VM-Thuan-2003/do_an_1/PROJECT/MACH/MACH_THUC/MACH_THUC_PROTEUS/MACH_THANH_PHAN/MACH_NGUON/imgs/tu_hoa_1000uF_25V.jpg

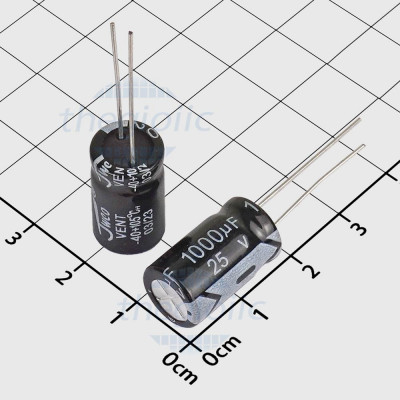
PROJECT/MACH/MACH_THUC/MACH_THUC_PROTEUS/MACH_THANH_PHAN/MACH_NGUON/imgs/tu_hoa_1000uF_25V.jpg
