VM-Thuan-2003/do_an_1/README.md

# PROJECT - ELECTRONIC - 1

> Name project: He thong giam sat nhiet do ho ca va cho ca an tu dong

## 2 MEMBER
* Vo Minh Thuan - 21161366
* Le Quang Thuong - 21161366

>Contact: 0355524273
