VM-Thuan-2003/do_an_1/PROJECT/REPORT/SO_DO_NGUYEN_Y.pdf

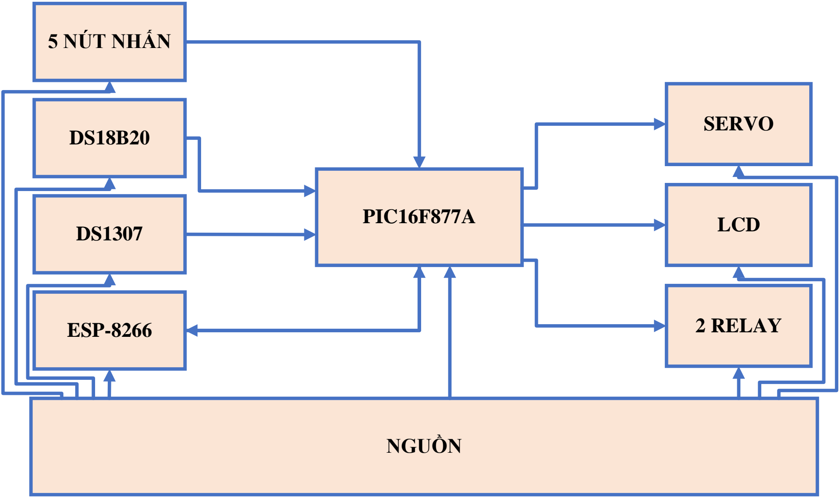
[picture p100: figure]
NGUỒN; PIC16F877A; ESP-8266; 5 NÚT NHẤN; LCD; 2 RELAY; SERVO
