VM-Thuan-2003/do_an_1/DOCUMENTS/Documents.docx

Đồ án 1

Hệ thống giám sát nhiệt độ bể cá và cho cá ăn tự động
