VM-Thuan-2003/do_an_1/PROJECT/MACH/MACH_THUC/MACH_THUC/MACH_THUC/PCF8574AT.STEP

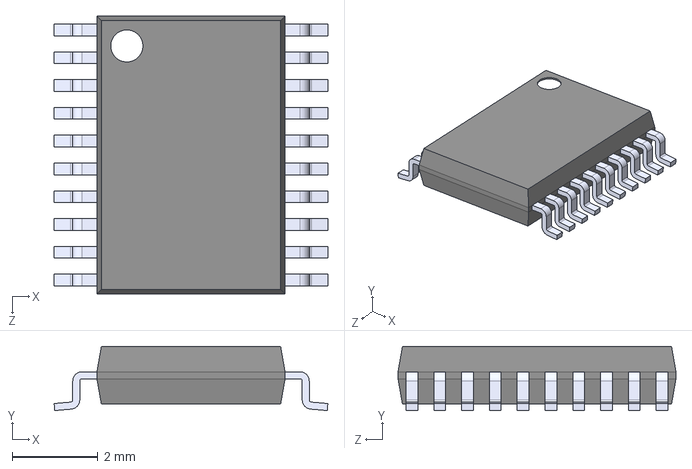
[picture p101: CAD file, 2024-05-01]
PROJECT/MACH/MACH_THUC/MACH_THUC/MACH_THUC/PCF8574AT.STEP
6.40 x 1.50 x 6.50 mm
