VM-Thuan-2003/do_an_1/PROJECT/MACH/MACH_THUC/MACH_THUC/MACH_THUC_V2/MACH_THUC_V2/SS12D07VG4/SS12D07VG4.step

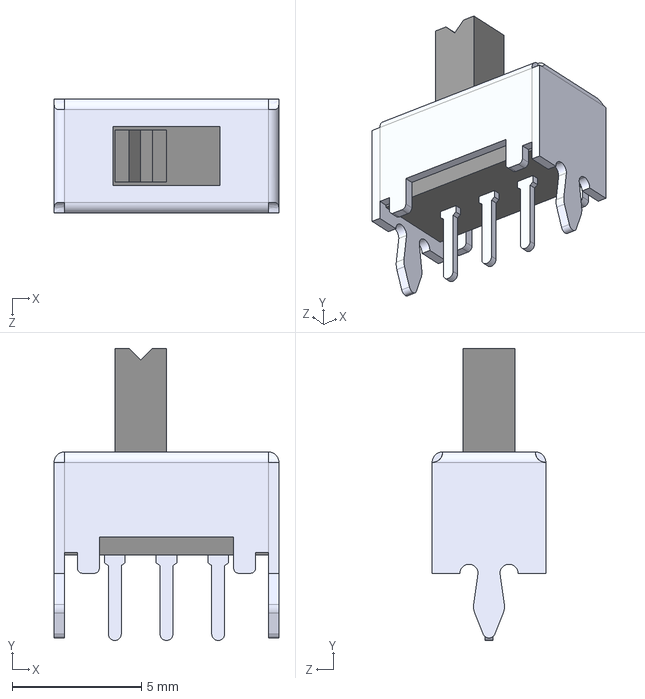
[picture p102: CAD file, 2024-05-01, an earlier design]
PROJECT/MACH/MACH_THUC/MACH_THUC/MACH_THUC_V2/MACH_THUC_V2/SS12D07VG4/SS12D07VG4.step
8.70 x 11.3 x 4.40 mm
