VM-Thuan-2003/do_an_1/PROJECT/MACH/MACH_THUC/MACH_THUC/MACH_THUC_V2/MACH_THUC_V2/1935161/1935161.step

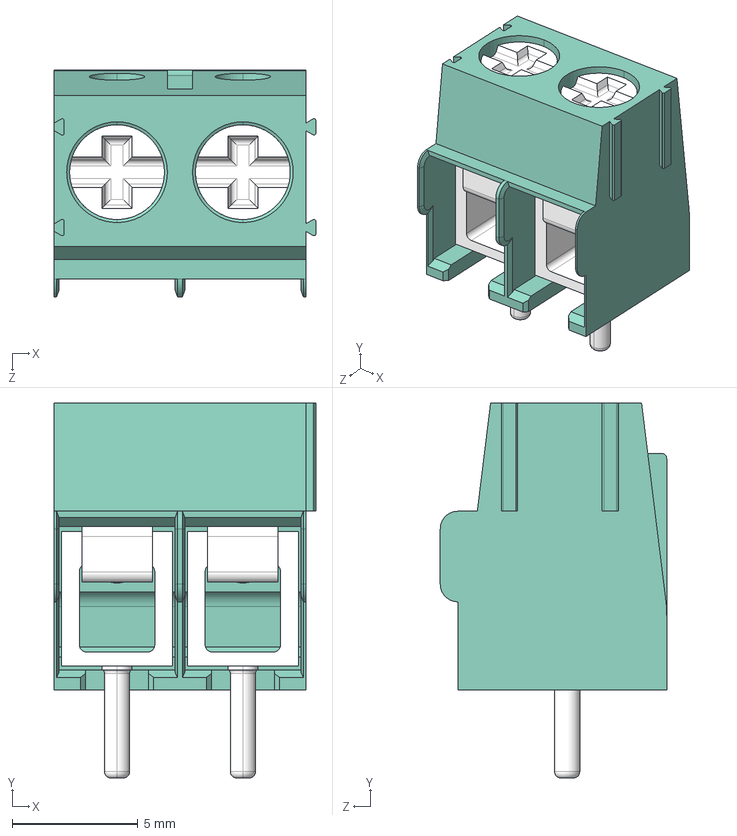
[picture p103: CAD file, 2024-05-01, an earlier design]
PROJECT/MACH/MACH_THUC/MACH_THUC/MACH_THUC_V2/MACH_THUC_V2/1935161/1935161.step
10.4 x 14.9 x 9.00 mm
