VM-Thuan-2003/do_an_1/PROJECT/REPORT/lưu đồ.drawio.pdf

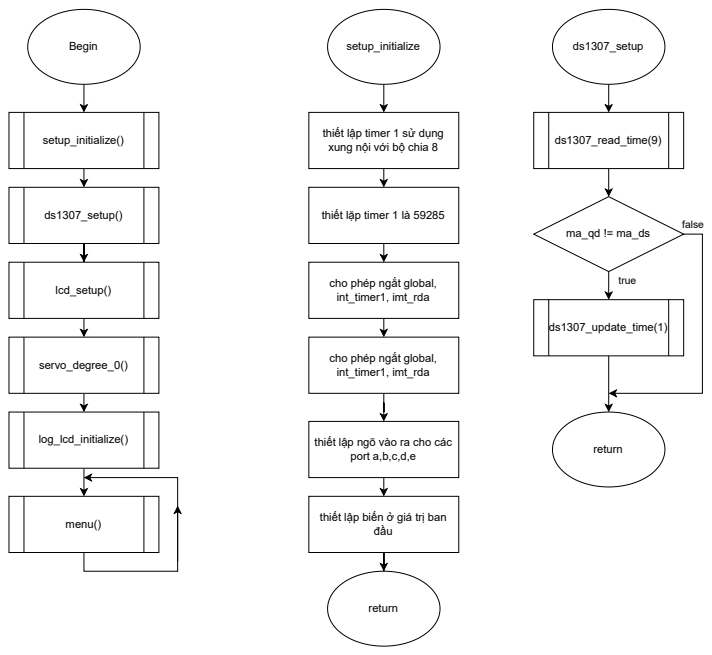
[picture p104: page 1]
Begin; setup_initialize(); ds1307_setup(); lcd_setup(); servo_degree_0(); log_lcd_initialize(); menu(); setup_initialize; đầu; return; ds1307_setup; ds1307_read_time(9); true; false; ds1307_update_time(1)

thiết lập timer 1 sử dụng
xung nội với bộ chia 8

thiết lặp timer 1 là 59285

cho phép ngắt global,
int_timer1, imt_rda

thiết lập ngõ vào ra cho các
port a,b,c,d,e

thiết lập biến ở giá trị ban

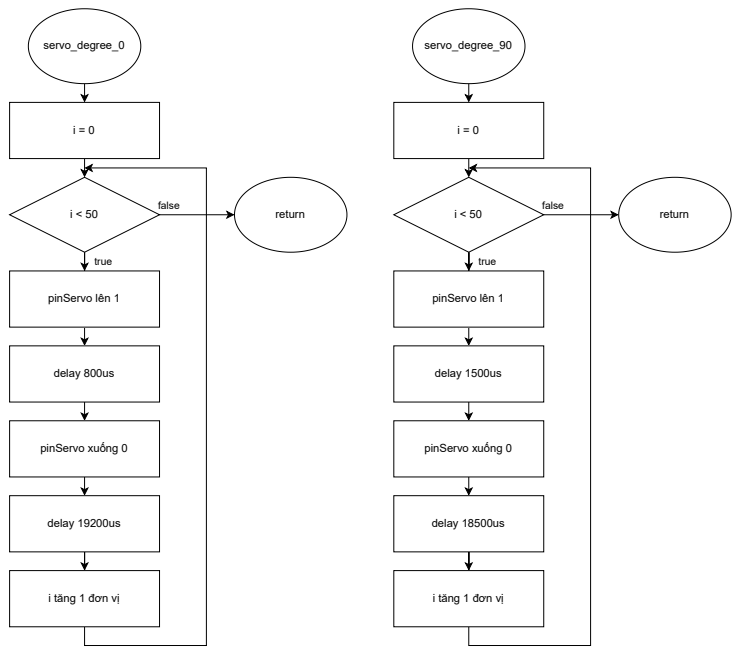
[picture p105: page 2]
servo_degree_0; true; false; pinServo lên 1; delay 800us; pinServo xuống 0; delay 19200us; return; servo_degree_90; delay 1500us; delay 18500us

i tăng 1 đơn vị

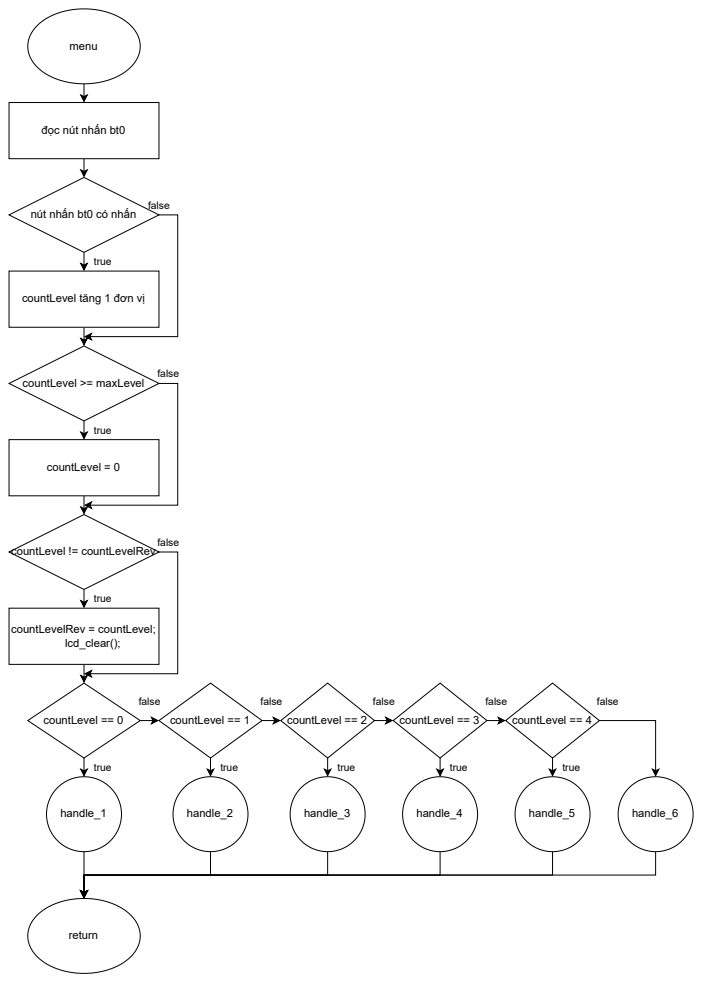
[picture p106: page 3]
menu; true; false; countLevel >= maxLevel; countLevel = 0; countLevel != countLevelRev; countLevelRev = countLevel; lcd_clear();; countLevel == 0; handle_1; countLevel == 1; handle_2; countLevel == 2; handle_3; countLevel == 3; handle_4; countLevel == 4; handle_5; handle_6; return

đọc nút nhấn bt0

false nút nhấn bt0 có nhấn

countLevel tăng 1 đơn vị

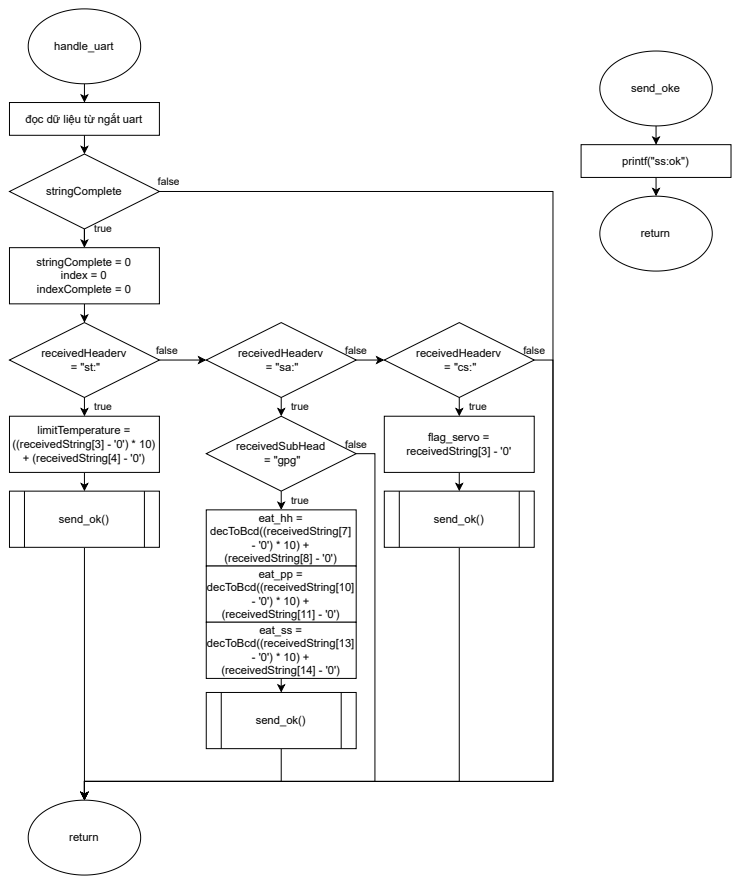
[picture p107: page 4]
handle_uart; true; false; stringComplete; stringComplete = 0 index = 0 indexComplete = 0; receivedHeaderv; limitTemperature = ((receivedString[3] - '0') * 10) + (receivedString[4] - '0'); send_ok(); receivedSubHead; = "gpg"; eat_hh = decToBcd((receivedString[7] - '0') * 10) + (receivedString[8] - '0') eat_pp = decToBcd((receivedString[10] - '0') * 10) + (receivedString[11] - '0') eat_ss = decToBcd((receivedString[13] - '0') * 10) + (receivedString[14] - '0')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

đọc dữ liệu từ ngắt uart

printf("ss:ok")

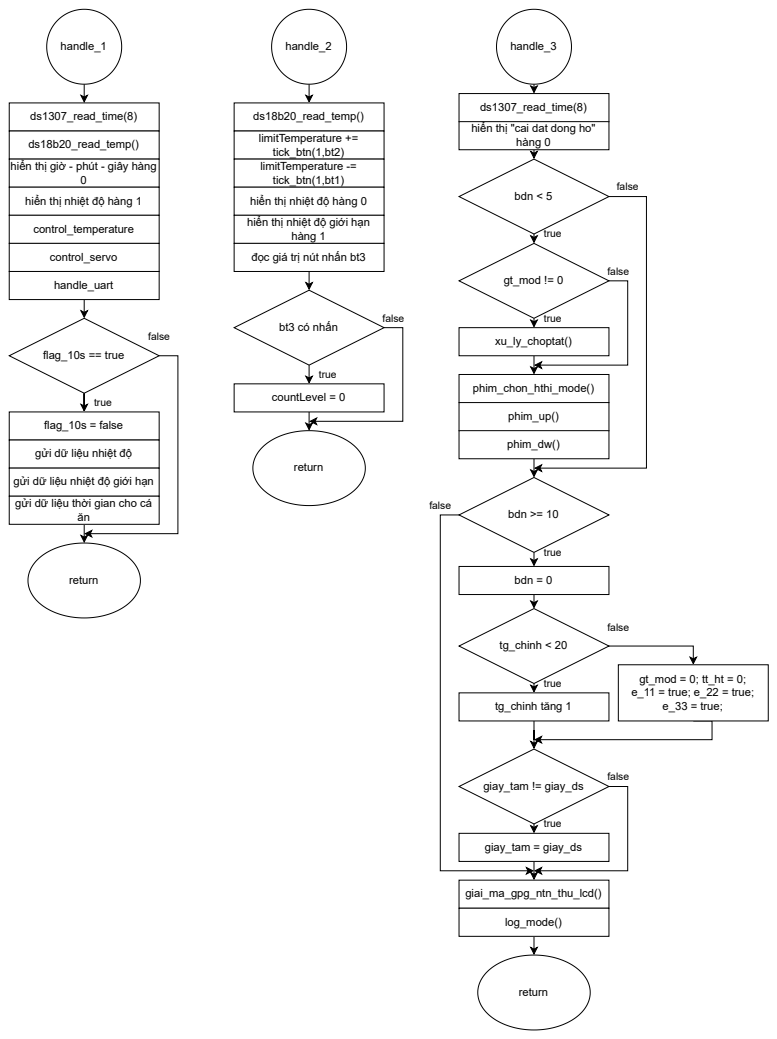
[picture p108: page 5]
ds1307_read_time(8); control_temperature; control_servo; handle_uart; handle_1; true; false; flag_10s == true; return; handle_2; hàng 1; handle_3; hàng 0; bdn < 5; gt_mod != 0; xu_ly_choptat(); bdn >= 10; bdn = 0; tg_chinh < 20; tg_chinh tăng 1; gt_mod = 0; tt_ht = 0; e_11 = true; e_22 = true; e_33 = true;; giay_tam != giay_ds; giay_tam = giay_ds; giai_ma_gpg_ntn_thu_lcd(); log_mode()

ds1307_read_time(8)
hiển thị "cai dat dong ho"

ds18b20_read_temp()
limitTemperature +=
tick_btn(1,bt2)
limitTemperature -=
tick_btn(1,bt1)
hiển thị nhiệt độ hàng 0
hiển thị nhiệt độ giới hạn

hiển thị giờ - phút - giây hàng

hiển thị nhiệt độ hàng 1

đọc giá trị nút nhấn bt3

false bt3 có nhấn

phim_chon_hthi_mode()

countLevel = 0

phim_up()

flag_10s = false

phim_dw()

gửi dữ liệu nhiệt độ

gửi dữ liệu nhiệt độ giới hạn

gửi dữ liệu thời gian cho cá

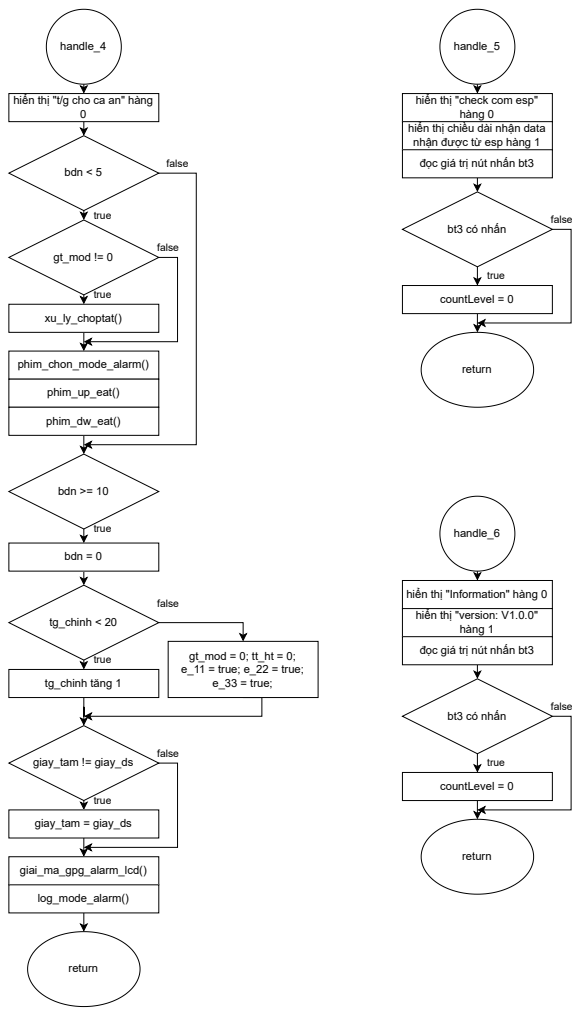
[picture p109: page 6]
handle_4; true; false; bdn < 5; gt_mod != 0; xu_ly_choptat(); bdn >= 10; bdn = 0; tg_chinh < 20; tg_chinh tăng 1; gt_mod = 0; tt_ht = 0; e_11 = true; e_22 = true; e_33 = true;; giay_tam != giay_ds; giay_tam = giay_ds; giai_ma_gpg_alarm_lcd(); log_mode_alarm(); return; handle_5; hàng 0; countLevel = 0; handle_6; hàng 1

hiển thị "t/g cho ca an" hàng

hiển thị "check com esp"

hiển thị chiều dài nhận data
nhận được từ esp hàng 1
đọc giá trị nút nhấn bt3

false bt3 có nhấn

phim_chon_mode_alarm()

phim_up_eat()

phim_dw_eat()

hiển thị "Information" hàng 0
hiển thị "version: V1.0.0"

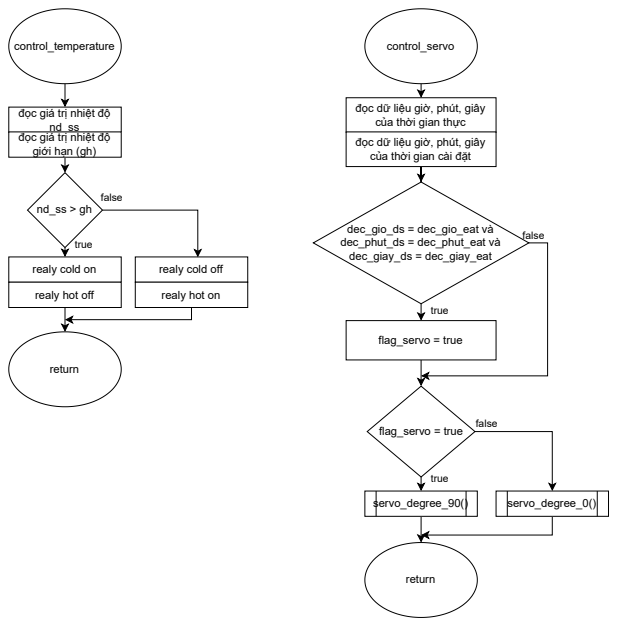
[picture p110: page 7]
control_temperature; true; false; return; control_servo; false dec_gio_ds = dec_gio_eat và dec_phut_ds = dec_phut_eat và dec_giay_ds = dec_giay_eat; flag_servo = true; servo_degree_90(); servo_degree_0()

đọc dữ liệu giờ, phút, giây
của thời gian thực
của thời gian cài đặt

đọc giá trị nhiệt độ
giới hạn (gh)

realy cold on

realy cold off

realy hot off

realy hot on

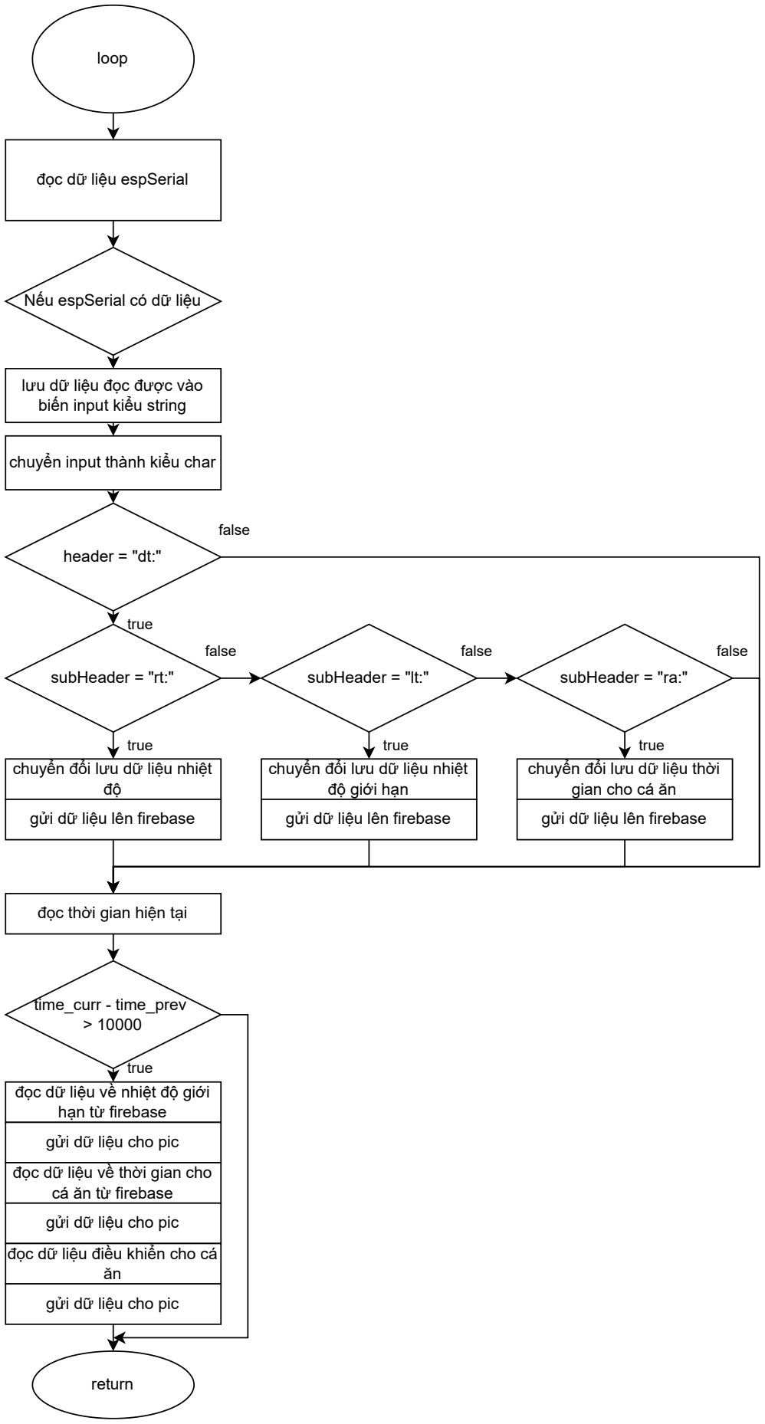
[picture p111: figure]
loop; đọc dữ liệu espSerial; Nếu espSerial có dữ liệu; lưu dữ liệu đọc được vào biến input kiểu string; chuyển input thành kiểu char; true; false; header = "dt:"; subHeader = "rt:"; chuyển đổi lưu dữ liệu nhiệt độ; gửi dữ liệu lên firebase; subHeader = "lt:"; chuyển đổi lưu dữ liệu nhiệt độ giới hạn; subHeader = "ra:"; chuyển đổi lưu dữ liệu thời gian cho cá ăn; đọc thời gian hiện tại; time_curr - time_prev > 10000; gửi dữ liệu cho pic; đọc dữ liệu điều khiển cho cá ăn; return

đọc dữ liệu về nhiệt độ giới hạn từ firebase

đọc dữ liệu về thời gian cho cá ăn từ firebase

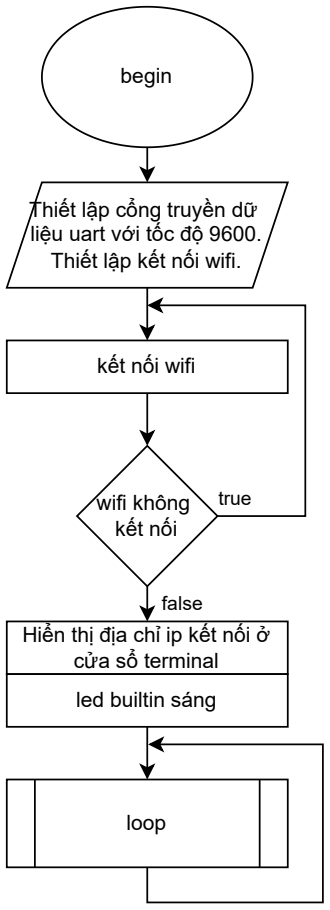
[picture p112: figure]
begin; Thiết lập cổng truyền dữ liệu uart với tốc độ 9600. Thiết lập kết nối wifi.; kết nối wifi; true; false; wifi không kết nối; Hiển thị địa chỉ ip kết nối ở cửa sổ terminal; led builtin sáng; loop
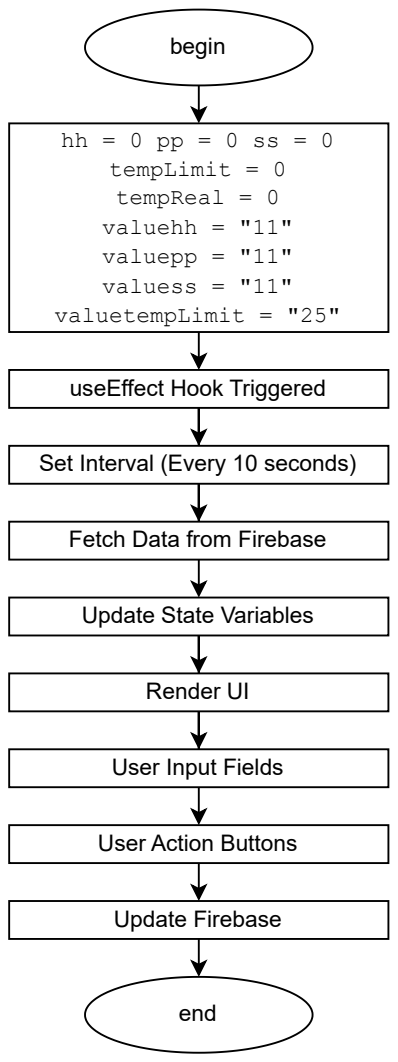
[picture p113: page 10]
begin; hh = 0 pp = 0 ss = 0 tempLimit = 0 tempReal = 0 valuehh = "11" valuepp = "11" valuess = "11" valuetempLimit = "25"; Render UI; Update Firebase; end

useEffect Hook Triggered

Set Interval (Every 10 seconds)

Fetch Data from Firebase

Update State Variables

User Input Fields

User Action Buttons
