VM-Thuan-2003/do_an_1/PROJECT/MACH/MACH_THUC/MACH_THUC/MACH_THUC/MACH_THUC.pdf

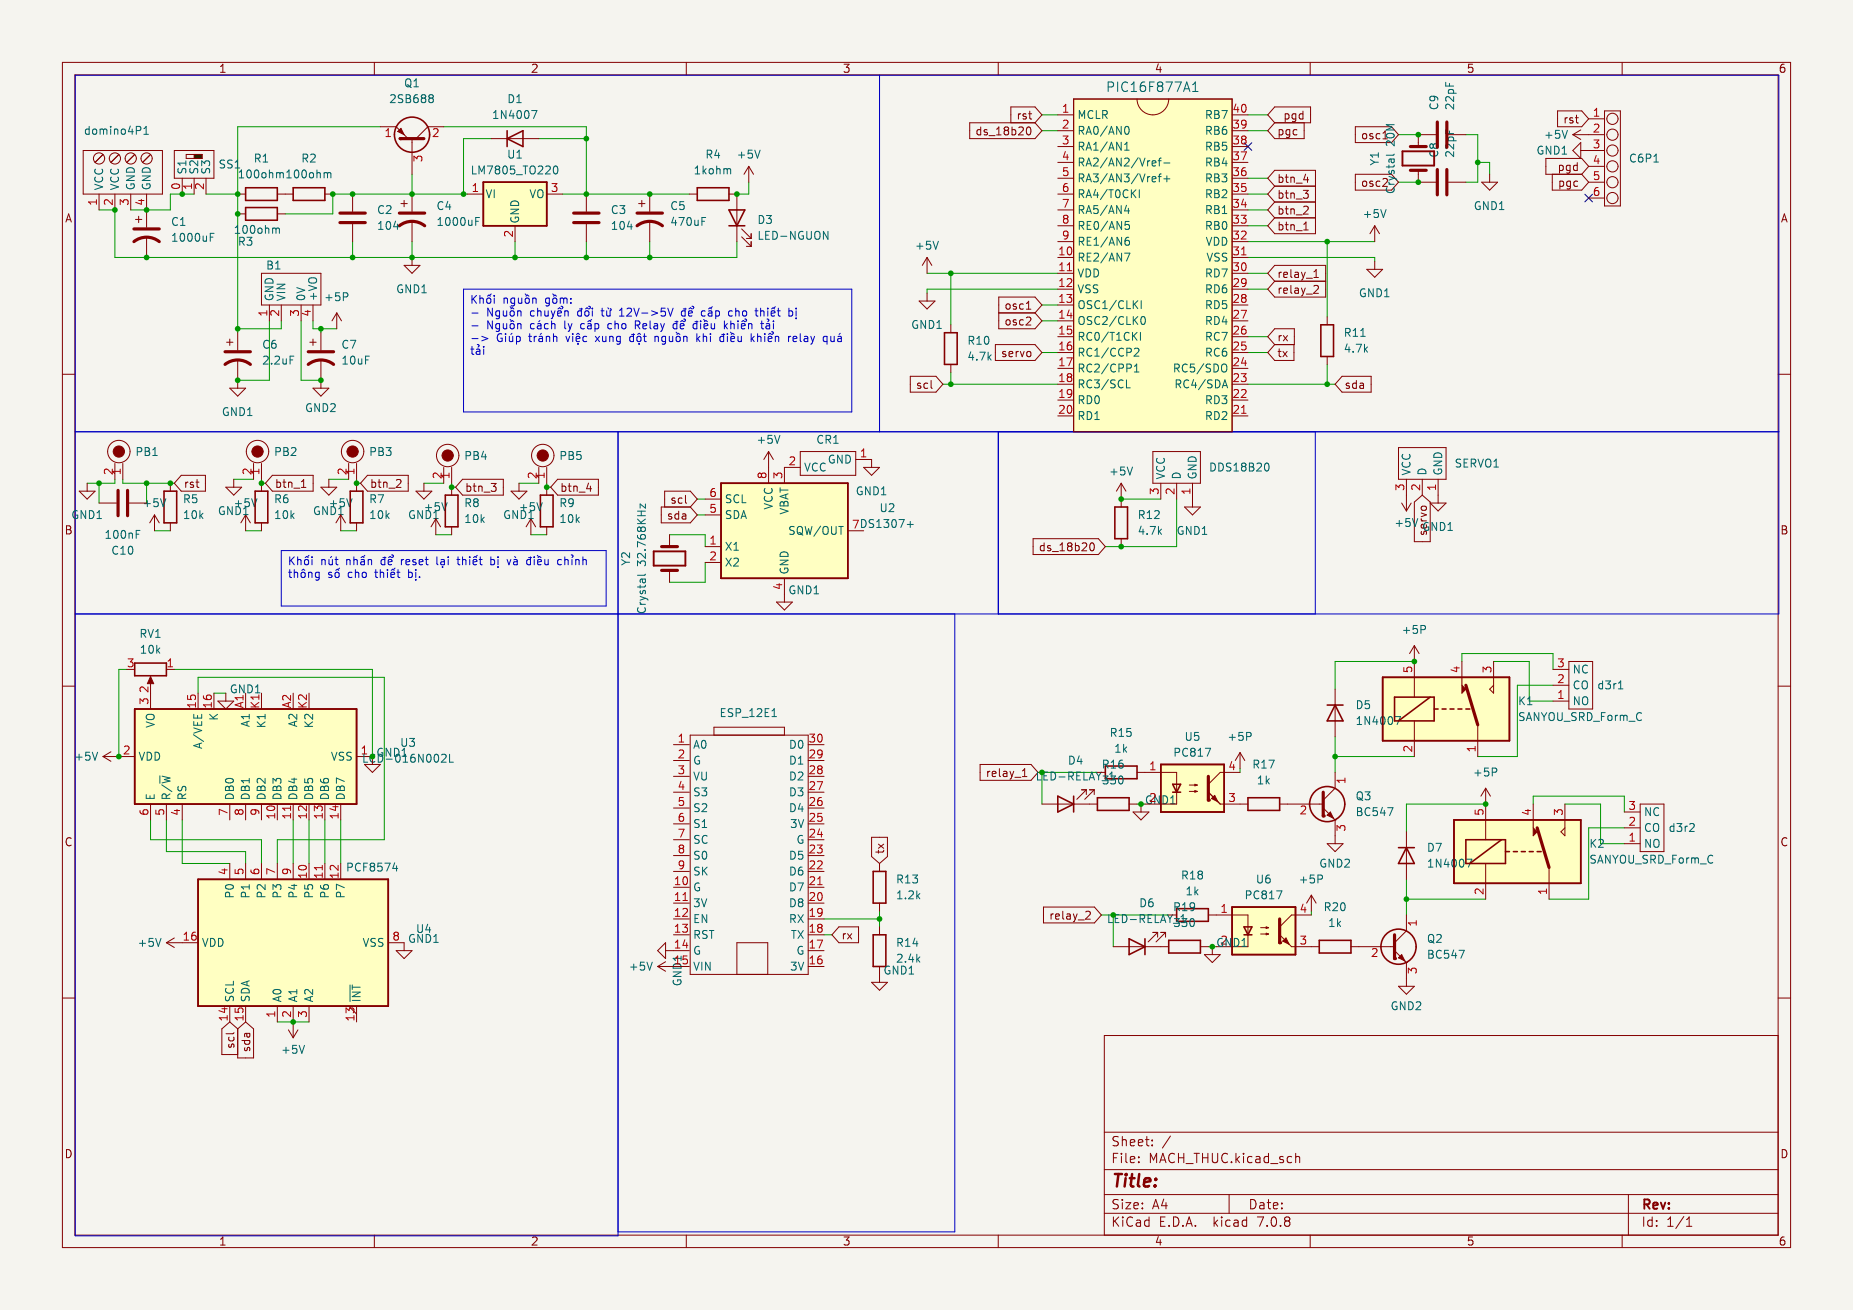
[picture p114: page 1]
