VM-Thuan-2003/do_an_1/(list of files, drawings)

Other design files:
PROJECT/MACH/MACH_THUC/MACH_THUC/MACH_THUC/MACH_THUC - Copy.dsn
PROJECT/MACH/MACH_THUC/MACH_THUC/MACH_THUC/MACH_THUC.dsn
PROJECT/MACH/MACH_THUC/MACH_THUC_PROTEUS/MACH_THANH_PHAN/MACH_NGUON/MACH_NGUON.pdsprj
PROJECT/MACH/MACH_THUC/MACH_THUC_PROTEUS/MACH_THANH_PHAN/MACH_NGUON/Project Backups/MACH_NGUON [20240402, 16-22-32].pdsprj
PROJECT/MACH/MACH_THUC/MACH_THUC_PROTEUS/MACH_THANH_PHAN/MACH_NGUON/Project Backups/MACH_NGUON [20240402, 16-22-33].pdsprj
PROJECT/MACH/MACH_THUC/MACH_THUC_PROTEUS/MACH_THANH_PHAN/MACH_NGUON/Project Backups/MACH_NGUON [20240402, 16-24-22].pdsprj
PROJECT/MACH/MACH_THUC/MACH_THUC_PROTEUS/MACH_THANH_PHAN/MACH_NGUON/Project Backups/MACH_NGUON [20240402, 16-24-23].pdsprj
PROJECT/MACH/MACH_THUC/MACH_THUC_PROTEUS/MACH_THANH_PHAN/MACH_NGUON/Project Backups/MACH_NGUON [20240402, 16-24-24].pdsprj
PROJECT/MACH/MACH_THUC/MACH_THUC_PROTEUS/MACH_THANH_PHAN/MACH_NGUON/Project Backups/MACH_NGUON [20240402, 16-24-25].pdsprj
PROJECT/MACH/MACH_THUC/MACH_THUC_PROTEUS/MACH_THANH_PHAN/MACH_NGUON/Project Backups/MACH_NGUON [20240403, 22-24-05].pdsprj
PROJECT/MACH/MACH_THUC/MACH_THUC_PROTEUS/MACH_THANH_PHAN/MACH_NGUON/Project Backups/MACH_NGUON [20240403, 22-24-06].pdsprj
PROJECT/MACH/MACH_THUC/MACH_THUC_PROTEUS/MACH_THANH_PHAN/MACH_RELAY/MACH_RELAY.pdsprj
PROJECT/MACH/MACH_THUC/MACH_THUC_PROTEUS/MACH_THANH_PHAN/MACH_RELAY/Project Backups/MACH_RELAY [20240403, 23-06-09].pdsprj
PROJECT/MACH/MACH_THUC/MACH_THUC_PROTEUS/MACH_THANH_PHAN/MACH_RELAY/Project Backups/MACH_RELAY [20240403, 23-26-44].pdsprj
PROJECT/MACH/MACH_THUC/MACH_THUC_PROTEUS/MACH_THANH_PHAN/MACH_RELAY/Project Backups/MACH_RELAY [20240403, 23-26-47].pdsprj
PROJECT/MACH/MACH_THUC/MACH_THUC_PROTEUS/MACH_THANH_PHAN/MACH_RELAY/Project Backups/MACH_RELAY [20240403, 23-26-48].pdsprj
PROJECT/MACH/MACH_THUC/MACH_THUC_PROTEUS/MACH_THANH_PHAN/MACH_RELAY/Project Backups/MACH_RELAY [20240403, 23-26-57].pdsprj
PROJECT/MACH/MACH_THUC/MACH_THUC_PROTEUS/MACH_THANH_PHAN/MACH_RELAY/Project Backups/MACH_RELAY [20240403, 23-36-37].pdsprj
PROJECT/MACH/MACH_THUC/MACH_THUC_PROTEUS/MACH_TONG_HOP/MACH_FINAL_V1.pdsprj
PROJECT/MACH/MACH_THUC/MACH_THUC_PROTEUS/MACH_TONG_HOP/MACH_TONG_HOP_V2.pdsprj
PROJECT/MACH/MACH_THUC/MACH_THUC_PROTEUS/MACH_TONG_HOP/Project Backups/MACH_TONG_HOP_V2 [20240403, 20-49-37].pdsprj
PROJECT/MACH/MACH_THUC/MACH_THUC_PROTEUS/MACH_TONG_HOP/Project Backups/MACH_TONG_HOP_V2 [20240403, 21-09-36].pdsprj
PROJECT/MACH/MACH_THUC/MACH_THUC_PROTEUS/MACH_TONG_HOP/Project Backups/MACH_TONG_HOP_V2 [20240403, 22-24-31].pdsprj
PROJECT/MACH/MACH_THUC/MACH_THUC_PROTEUS/MACH_TONG_HOP/Project Backups/MACH_TONG_HOP_V2 [20240403, 23-36-59].pdsprj
PROJECT/MACH/MACH_THUC/MACH_THUC_PROTEUS/MACH_TONG_HOP/Project Backups/MACH_TONG_HOP_V2 [20240403, 23-39-41].pdsprj
PROJECT/MACH/MACH_THUC/MACH_THUC_PROTEUS/MACH_TONG_HOP/Project Backups/MACH_TONG_HOP_V2 [20240403, 23-45-08].pdsprj
PROJECT/MACH/MACH_THUC/MACH_THUC_PROTEUS/MACH_TONG_HOP/Project Backups/MACH_TONG_HOP_V2 [20240403, 23-45-09].pdsprj
PROJECT/MACH/MACH_THUC/MACH_THUC_PROTEUS/MACH_TONG_HOP/Project Backups/MACH_TONG_HOP_V2 [20240403, 23-45-14].pdsprj
PROJECT/MACH/MO_PHONG/CIRCIL_FINAL/MACH_FINAL.pdsprj
PROJECT/MACH/MO_PHONG/CIRCIL_FINAL/Project Backups/MACH_FINAL [20240315, 19-27-27].pdsprj
PROJECT/MACH/MO_PHONG/CIRCIL_FINAL/Project Backups/MACH_FINAL [20240315, 19-27-28].pdsprj
PROJECT/MACH/MO_PHONG/CIRCIL_FINAL/Project Backups/MACH_FINAL [20240315, 19-32-34].pdsprj
PROJECT/MACH/MO_PHONG/CIRCIL_FINAL/Project Backups/MACH_FINAL [20240317, 08-32-04].pdsprj
PROJECT/MACH/MO_PHONG/CIRCIL_FINAL/Project Backups/MACH_FINAL [20240319, 15-47-52].pdsprj
PROJECT/MACH/MO_PHONG/CIRCIL_FINAL/Project Backups/MACH_FINAL [20240319, 15-49-03].pdsprj
PROJECT/MACH/MO_PHONG/CIRCIL_FINAL/Project Backups/MACH_FINAL [20240319, 15-49-04].pdsprj
PROJECT/MACH/MO_PHONG/CIRCIL_FINAL/Project Backups/MACH_FINAL [20240320, 13-40-21].pdsprj
PROJECT/MACH/MO_PHONG/CIRCIL_FINAL/Project Backups/MACH_FINAL [20240320, 13-40-22].pdsprj
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
