VM-Thuan-2003/do_an_1/PROJECT/MACH/MACH_THUC/MACH_THUC/MACH_THUC_V2/MACH_THUC_V2/MACH_THUC_V2.kicad_pcb

## KiCad design PROJECT/MACH/MACH_THUC/MACH_THUC/MACH_THUC_V2/MACH_THUC_V2/MACH_THUC_V2.kicad_pcb (2024-05-03, an earlier design)

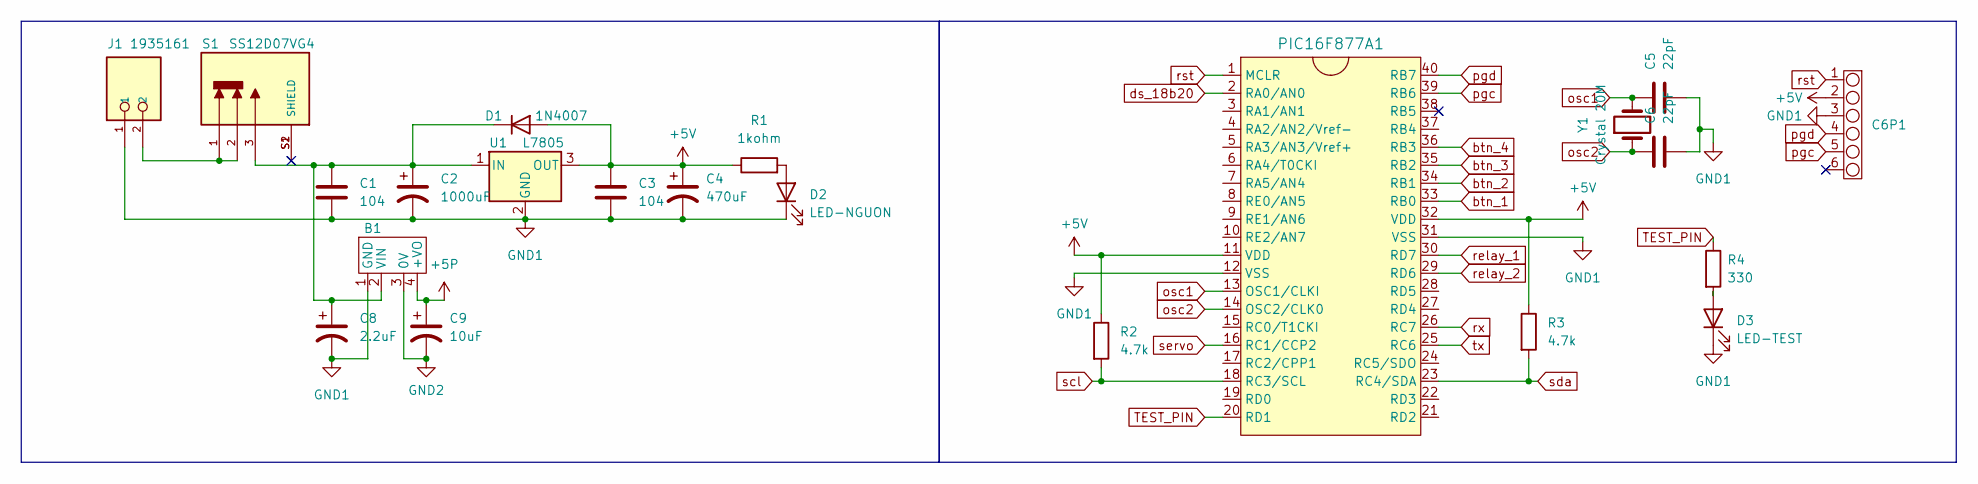
[picture p115: schematic MACH_THUC_V2.kicad_sch]

Parts:
B1: B1205S-1WR3_12_5V
C1, C3: 104; CAP_104
C2: 1000uF; CAP_1000uF
C4: 470uF; CAP_470uF
C5, C6: 22pF; CAP_104
C6P1: CONNECT_6PIN
C8: 2.2uF; CAP_2.2uF
C9: 10uF; CAP_10uF
D1: 1N4007
D2: LED-NGUON; LED_5MM
D3: LED-TEST; LED_5MM
J1: 1935161; PHOENIX_1935161; PARTREV 14.12.2022
PIC16F877A1: PIC_16F877A
R1: 1kohm; RES_DEFAULT
R2, R3: 4.7k; RES_DEFAULT
R4: 330; RES_DEFAULT
S1: SS12D07VG4; SW_SS12D07VG4; PARTREV 1
U1: L7805; TO255P1020X450X2000-3
Y1: Crystal 20M; crytal_20M

Connections:
pgd: C6P1.4, PIC16F877A1.40 (RB7)
+5P: B1.4 (+VO), C9.1
+5V: C3.1, C4.1, C6P1.2, D1.2 (A), PIC16F877A1.11 (VDD), PIC16F877A1.32 (VDD), R1.1, R2.1, R3.1, U1.3 (OUT)
GND1: B1.1 (GND), C1.2, C2.2, C3.2, C4.2, C5.2, C6.2, C6P1.3, C8.2, D2.1 (K), D3.1 (K), J1.1, PIC16F877A1.12 (VSS), PIC16F877A1.31 (VSS), U1.2 (GND)
GND2: B1.3 (0V), C9.2
unnamed: B1.2 (VIN), C1.1, C2.1, C8.1, D1.1 (K), S1.3, U1.1 (IN)
unnamed: D2.2 (A), R1.2
unnamed: D3.2 (A), R4.2
unnamed: J1.2, S1.1, S1.2
TEST_PIN: PIC16F877A1.20 (RD1), R4.1
btn_1: PIC16F877A1.33 (RB0)
btn_2: PIC16F877A1.34 (RB1)
btn_3: PIC16F877A1.35 (RB2)
btn_4: PIC16F877A1.36 (RB3)
ds_18b20: PIC16F877A1.2 (RA0/AN0)
osc1: C5.1, PIC16F877A1.13 (OSC1/CLKI), Y1.2
osc2: C6.1, PIC16F877A1.14 (OSC2/CLK0), Y1.1
pgc: C6P1.5, PIC16F877A1.39 (RB6)
relay_1: PIC16F877A1.30 (RD7)
relay_2: PIC16F877A1.29 (RD6)
rst: C6P1.1, PIC16F877A1.1 (MCLR)
rx: PIC16F877A1.26 (RC7)
scl: PIC16F877A1.18 (RC3/SCL), R2.2
sda: PIC16F877A1.23 (RC4/SDA), R3.2
servo: PIC16F877A1.16 (RC1/CCP2)
tx: PIC16F877A1.25 (RC6)

Board: 2 copper layers, 22 parts (0 on the bottom side), 16 nets, no tracks yet.
