VM-Thuan-2003/do_an_1/PROJECT/MACH/MACH_THUC/MACH_THUC/MACH_THUC/MACH_THUC.kicad_pcb

## KiCad design PROJECT/MACH/MACH_THUC/MACH_THUC/MACH_THUC/MACH_THUC.kicad_pcb (2024-05-01)

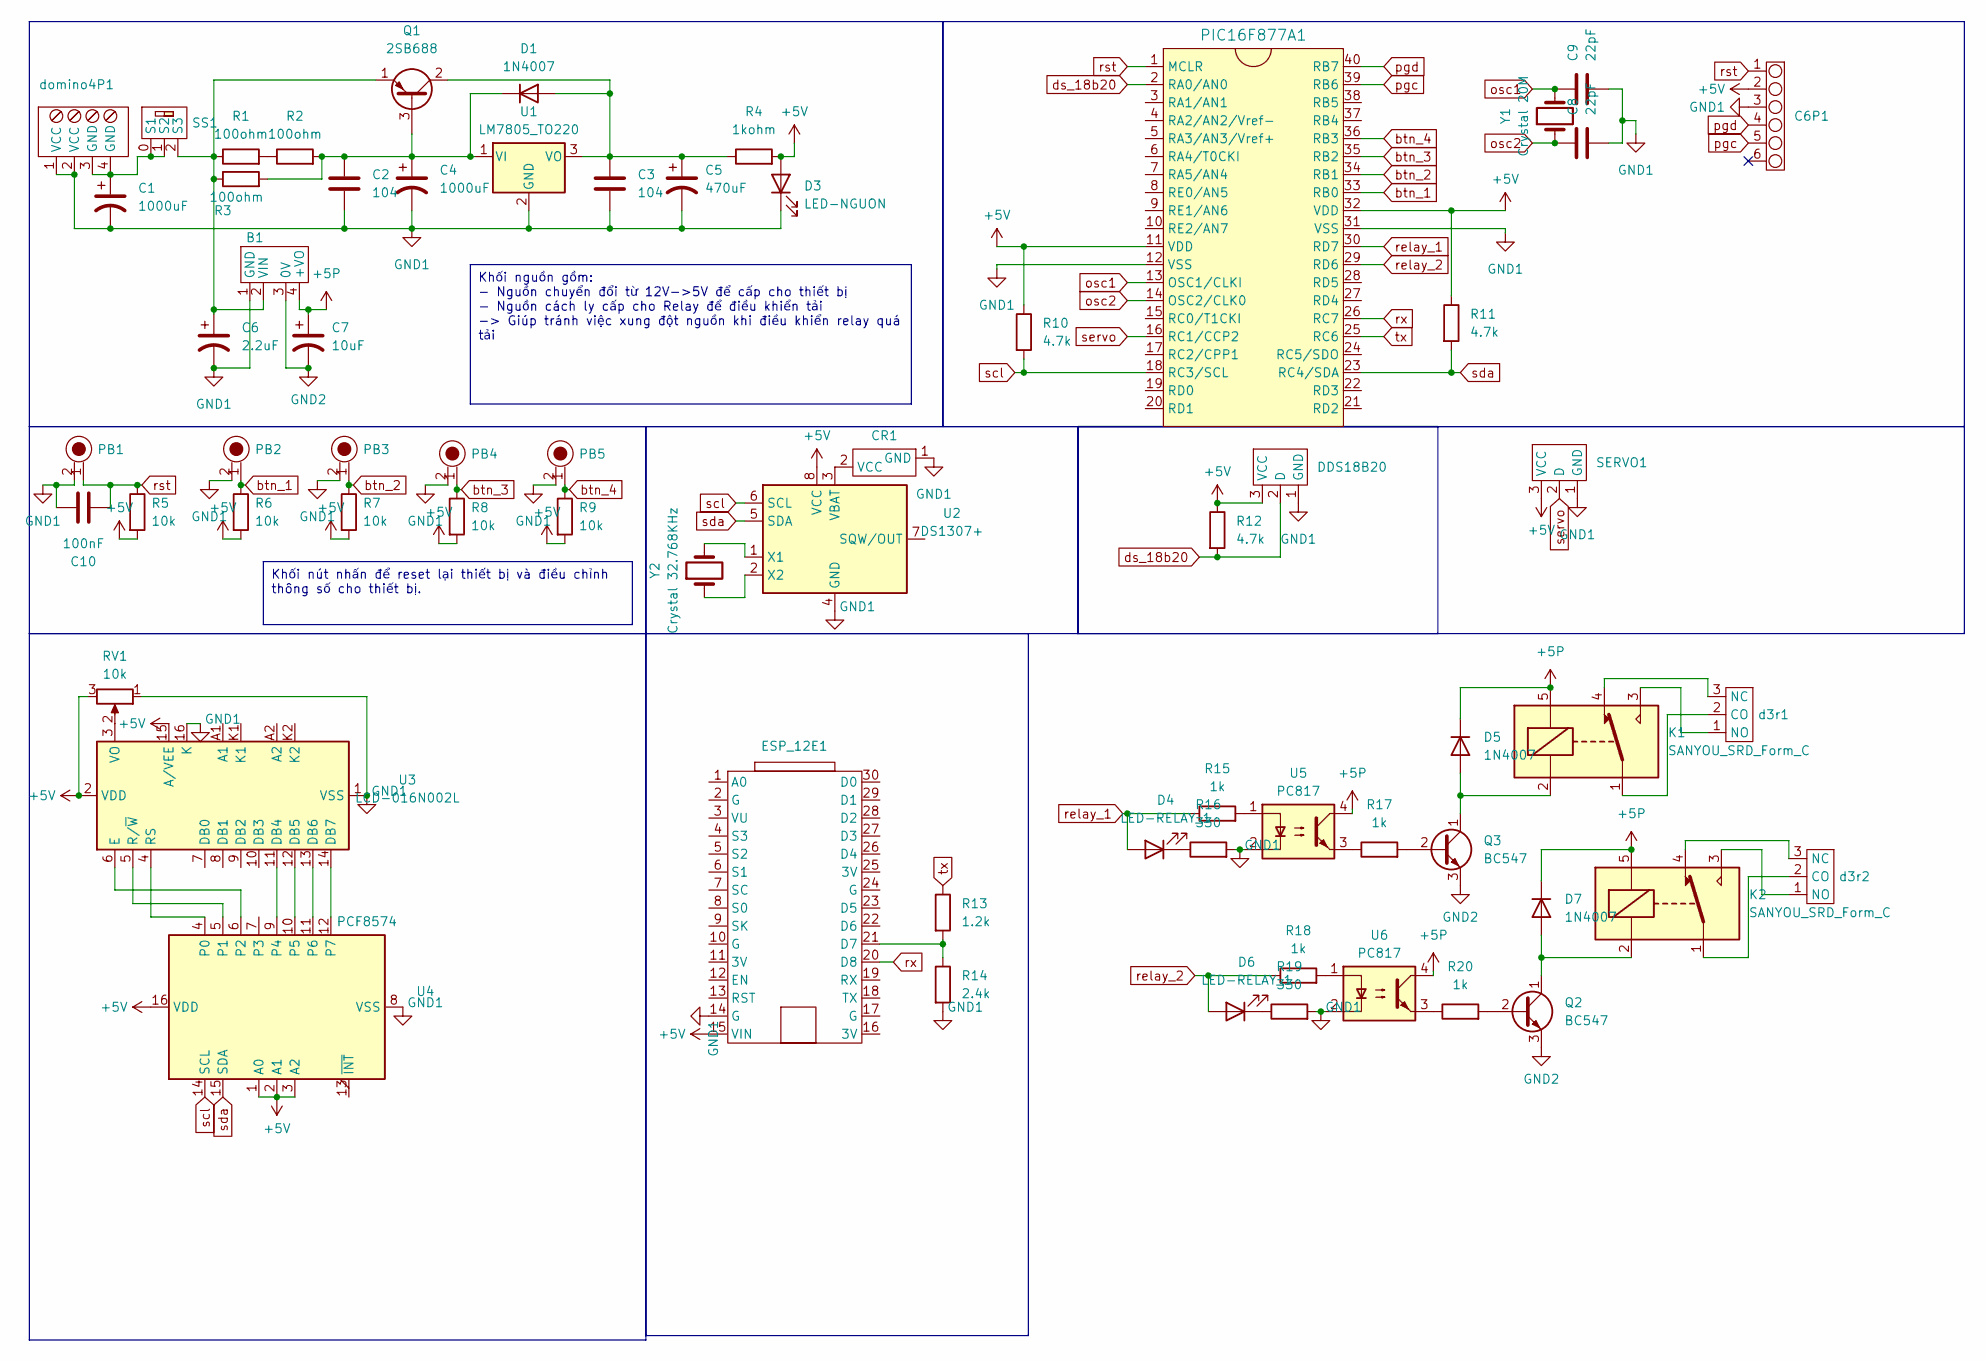
[picture p116: schematic MACH_THUC.kicad_sch]

Parts:
B1: B1205S-1WR3_12_5V
C1, C4: 1000uF; CAP_1000uF
C2, C3: 104; CAP_104
C5: 470uF; CAP_470uF
C6: 2.2uF; CAP_2.2uF
C6P1: CONNECT_6PIN
C7: 10uF; CAP_10uF
C8, C9: 22pF; CAP_104
C10: 100nF; CAP_104
CR1: cr2032
D1, D5, D7: 1N4007
D3: LED-NGUON; LED_5MM
D4, D6: LED-RELAY_1; LED_5MM
DDS18B20: DOMINO_3
ESP_12E1: ESP8266_12E
K1, K2: SANYOU_SRD_Form_C; Relay_SPDT_SANYOU_SRD_Series_Form_C
PB1, PB2, PB3, PB4, PB5: push_button
PIC16F877A1: PIC_16F877A
Q1: 2SB688; TO-218-3_Vertical
Q2, Q3: BC547; TO-92_Inline
R1, R2, R3: 100ohm; RES_1ohm_1w
R4: 1kohm; RES_DEFAULT
R5, R6, R7, R8, R9: 10k; RES_DEFAULT
R10, R11, R12: 4.7k; RES_DEFAULT
R13: 1.2k; RES_DEFAULT
R14: 2.4k; RES_DEFAULT
R15, R17, R18, R20: 1k; RES_DEFAULT
R16, R19: 330; RES_DEFAULT
RV1: 10k; RM065-103
SERVO1: DOMINO_3
SS1: SWITCH_SLIDER
U1: LM7805_TO220; TO-220-3_Vertical
U2: DS1307+; DIP-8_W7.62mm
U3: LCD-016N002L
U4: PCF8574; SOIC127P1032X265-16N
U5, U6: PC817; DIP-4_W7.62mm
Y1: Crystal 20M; crytal_20M
Y2: Crystal 32.768KHz; crytal_32.768KHz
d3r1, d3r2: DOMINO_3_5mm
domino4P1: DOMINO_4_5mm

Connections:
pgd: C6P1.4, PIC16F877A1.40 (RB7)
+5P: B1.4 (+VO), C7.1, D5.1 (K), D7.1 (K), K1.5, K2.5, U5.4, U6.4
+5V: C6P1.2, D3.2 (A), DDS18B20.3 (VCC), ESP_12E1.15 (VIN), PIC16F877A1.11 (VDD), PIC16F877A1.32 (VDD), R4.2, R5.2, R6.2, R7.2, R8.2, R9.2, R10.1, R11.1, R12.1, RV1.3, SERVO1.3 (VCC), U2.8 (VCC), U3.2 (VDD), U3.15 (A/VEE), U4.1 (A0), U4.2 (A1), U4.3 (A2), U4.16 (VDD)
GND1: B1.1 (GND), C1.2, C2.2, C3.2, C4.2, C5.2, C6.2, C6P1.3, C8.2, C9.2, C10.2, CR1.1 (GND), D3.1 (K), DDS18B20.1 (GND), ESP_12E1.14 (G), PB1.2, PB2.2, PB3.2, PB4.2, PB5.2, PIC16F877A1.12 (VSS), PIC16F877A1.31 (VSS), R14.2, R16.2, R19.2, RV1.1, SERVO1.1 (GND), U1.2 (GND), U2.4 (GND), U3.1 (VSS), U3.16 (K), U4.8 (VSS), U5.2, U6.2, domino4P1.1 (VCC), domino4P1.2 (VCC)
GND2: B1.3 (0V), C7.2, Q2.3 (E), Q3.3 (E)
unnamed: B1.2 (VIN), C6.1, Q1.1 (E), R1.1, R3.1, SS1.2 (S3)
unnamed: CR1.2 (VCC), U2.3 (VBAT)
unnamed: C3.1, C5.1, D1.2 (A), Q1.2 (C), R4.1, U1.3 (VO)
unnamed: C2.1, C4.1, D1.1 (K), Q1.3 (B), R2.2, R3.2, U1.1 (VI)
unnamed: D4.1 (K), R16.1
unnamed: D5.2 (A), K1.2, Q3.1 (C)
unnamed: D6.1 (K), R19.1
unnamed: D7.2 (A), K2.2, Q2.1 (C)
unnamed: ESP_12E1.21 (D7), R13.2, R14.1
unnamed: Q2.2 (B), R20.2
unnamed: Q3.2 (B), R17.2
unnamed: R1.2, R2.1
unnamed: R15.2, U5.1
unnamed: R17.1, U5.3
unnamed: R18.2, U6.1
unnamed: R20.1, U6.3
unnamed: C1.1, SS1.0 (S1), SS1.1 (S2), domino4P1.3 (GND), domino4P1.4 (GND)
unnamed: U2.1 (X1), Y2.2
unnamed: U2.2 (X2), Y2.1
unnamed: U3.11 (DB4), U4.9 (P4)
unnamed: U3.12 (DB5), U4.10 (P5)
unnamed: U3.13 (DB6), U4.11 (P6)
unnamed: U3.14 (DB7), U4.12 (P7)
unnamed: U3.6 (E), U4.6 (P2)
unnamed: U3.4 (RS), U4.4 (P0)
unnamed: U3.5 (R/~W), U4.5 (P1)
unnamed: RV1.2, U3.3 (VO)
unnamed: K1.1, d3r1.2 (CO)
unnamed: K1.4, d3r1.3 (NC)
unnamed: K1.3, d3r1.1 (NO)
unnamed: K2.1, d3r2.2 (CO)
unnamed: K2.4, d3r2.3 (NC)
unnamed: K2.3, d3r2.1 (NO)
btn_1: PB2.1, PIC16F877A1.33 (RB0), R6.1
btn_2: PB3.1, PIC16F877A1.34 (RB1), R7.1
btn_3: PB4.1, PIC16F877A1.35 (RB2), R8.1
btn_4: PB5.1, PIC16F877A1.36 (RB3), R9.1
ds_18b20: DDS18B20.2 (D), PIC16F877A1.2 (RA0/AN0), R12.2
osc1: C9.1, PIC16F877A1.13 (OSC1/CLKI), Y1.2
osc2: C8.1, PIC16F877A1.14 (OSC2/CLK0), Y1.1
pgc: C6P1.5, PIC16F877A1.39 (RB6)
relay_1: D4.2 (A), PIC16F877A1.30 (RD7), R15.1
relay_2: D6.2 (A), PIC16F877A1.29 (RD6), R18.1
rst: C6P1.1, C10.1, PB1.1, PIC16F877A1.1 (MCLR), R5.1
rx: ESP_12E1.20 (D8), PIC16F877A1.26 (RC7)
scl: PIC16F877A1.18 (RC3/SCL), R10.2, U2.6 (SCL), U4.14 (SCL)
sda: PIC16F877A1.23 (RC4/SDA), R11.2, U2.5 (SDA), U4.15 (SDA)
servo: PIC16F877A1.16 (RC1/CCP2), SERVO1.2 (D)
tx: PIC16F877A1.25 (RC6), R13.1

Notes on the sheet:
Khối nguồn gồm: - Nguồn chuyển đổi từ 12V->5V để cấp cho thiết bị - Nguồn cách ly cấp cho Relay để điều khiển tải -> Giúp tránh việc xung đột nguồn khi điều khiển relay quá tải
Khối nút nhấn để reset lại thiết bị và điều chỉnh thông số cho thiết bị.

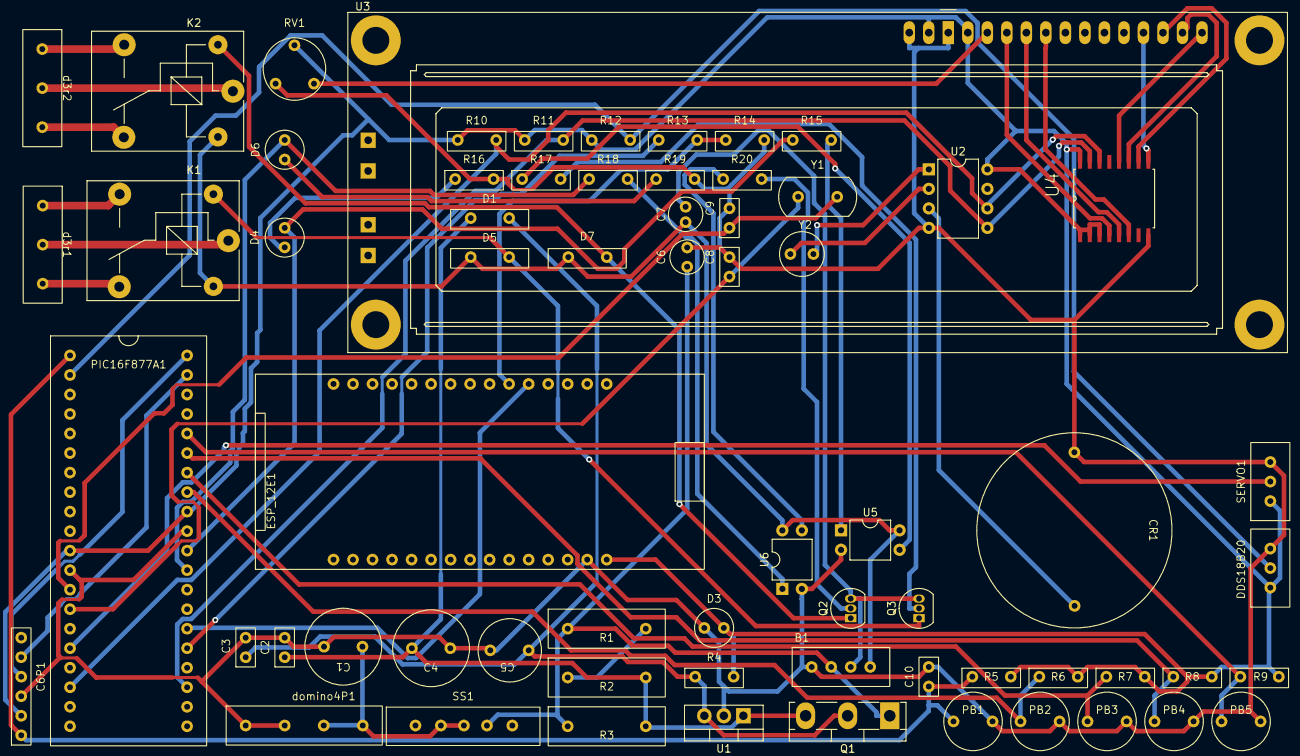
[picture p117: board MACH_THUC.kicad_pcb from above]

Board: 2 copper layers, 66 parts (0 on the bottom side), 54 nets.
