VM-Thuan-2003/do_an_1/PROJECT/CODE_FINALL_C/define_pic16f.c

//! config mode to operation of pic16f877a
#include <16f877a.h>
#device  adc=10
#fuses   hs, nowdt, put, noprotect, nolvp
#use     delay(clock=20MHz) 
#use     i2c(master,slow,sda=pin_c4,scl=pin_c3)
#use     rs232(baud=9600, xmit=PIN_C6, rcv=PIN_C7)
#use fast_io(c)

#include <library_uart.c>

//! define name again to user
#define usi8  unsigned int8
#define usi16 unsigned int16
#define usi32 unsigned int32
#define si8   signed   int8
#define si16  signed   int16
#define si32  signed   int32
#define bool int1


//! define button to use
#ifndef bt0
#define bt0    pin_b0
#endif

#ifndef bt1
#define bt1    pin_b1
#endif

#ifndef bt2
#define bt2    pin_b2
#endif

#ifndef bt3
#define bt3    pin_b3
#endif

//! define pin sensors
#define pin_ds18b20 pin_a0

//! define pin controls
#ifndef pinServo
#define pinServo    pin_c1
#endif

#ifndef pinDLCold
#define pinDLCold     pin_d6
#endif

#ifndef pinDLHot
#define pinDLHot      pin_d7
#endif

#ifndef ledTest
#define ledTest      pin_b5
#endif

void setup_initialize(){
   enable_interrupts(global);
   enable_interrupts(int_rda);
   set_tris_c(0x98); output_c(0x98);
   set_tris_b(0xdf);
}
