VM-Thuan-2003/do_an_1/PROJECT/CODE_FINALL_C/main.c

#include <library_project.c>

void loop(){
//! function to access for change limit temperature, change time for time rtc, change time clock for eat fish, check com with esp, log version sys
   menu();
}

void main(){

//! setup enviroments
   setup_initialize();
   
//! setup ds1307 rtc
   ds1307_setup();

//! setup lcd display
   lcd_setup();

//! setup servo initialize is 0 degree
   servo_degree_0();

//! display info include: name project and name university
   log_lcd_initialize();
   
   printf("Hello from PIC16F877A!");
   while(true){
//! loop function is function suport in process of system
      loop();
   }
}
