VM-Thuan-2003/do_an_1/PROJECT/CODE_FINALL_C/library_i2c.c

#define pcf8574_addr_wr 0x4E // 0b01001110
#define pcf8574_addr_rd 0x4F // 0b01001111

//! i2c reset
void i2c_reset()
{
   i2c_start();
   i2c_stop();
}

//! i2c setup write for pcf8574
void i2c_setup_write()
{
   i2c_start();
   i2c_write(pcf8574_addr_wr);
}

//! i2c write 1byte for pcf8574
void i2c_write_1byte(usi8 payload)
{
   i2c_start();
   i2c_write(pcf8574_addr_wr);
   i2c_write(payload);
   i2c_stop();
}
