VM-Thuan-2003/do_an_1/PROJECT/CODE_FINALL_C/library_project.c

/*
xxxxxxxxxxxxxxxxxxxxxxxxxxxxxxxxxxxxxxxxxxxxxxxxxxxxxxxxxxxxxxxxxxxxxx
                       SU PHAM KY THUAT - TP.HCM
 DO AN 1 - HIEU CHINH NHIET DO HO CA VA CHO CA AN TU DONG - KET NOI ESP

   THANH VIEN:
      VO MINH THUAN   - 21161366
      LE QUANG THUONG - 21161367
xxxxxxxxxxxxxxxxxxxxxxxxxxxxxxxxxxxxxxxxxxxxxxxxxxxxxxxxxxxxxxxxxxxxxx
*/
#include <define_pic16f.c>
//!#include <library_button.c>
#include <library_i2c.c>
#include <library_lcd_i2c.c>
//!#include <library_ds1307_i2c.c>
//!#include <library_ds18b20.c>
//!#include <library_change_rtc.c>
//!#include <library_change_alarm_eat.c>
//!#include <library_control_chiller.c>
//!#include <library_menu.c>
