VM-Thuan-2003/do_an_1/PROJECT/CODE_FINNAL/library_ds1307_i2c.c

#define ds13_addr_wr 0xd0
#define ds13_addr_rd 0xd1

//cap nhat time: giay-phut-gio-thu-ngay-thang-nam-madk_msds
usi8 time_w[9]={0x31,0x15,0x15,0x04,0x25,0x10,0x23,0x90,0x91};
usi8 time_r[9]={0x30,0x30,0x10,0x08,0x20,0x02,0x20,0x90,0x91};

#define dec_giay_eat  ds1307_bcdToDec(eat_ss)
#define dec_phut_eat  ds1307_bcdToDec(eat_pp)
#define dec_gio_eat   ds1307_bcdToDec(eat_hh)

#define dec_giay_ds  ds1307_bcdToDec(time_r[0])
#define dec_phut_ds  ds1307_bcdToDec(time_r[1])
#define dec_gio_ds   ds1307_bcdToDec(time_r[2])
#define dec_thu_ds   ds1307_bcdToDec(time_r[3])
#define dec_ngay_ds  ds1307_bcdToDec(time_r[4])
#define dec_thang_ds ds1307_bcdToDec(time_r[5])
#define dec_nam_ds   ds1307_bcdToDec(time_r[6])

#define giay_ds  time_r[0]
#define phut_ds  time_r[1]
#define gio_ds   time_r[2]
#define thu_ds   time_r[3]
#define ngay_ds  time_r[4]
#define thang_ds time_r[5]
#define nam_ds   time_r[6]

#define ma_qd   time_w[8]
#define ma_ds   time_r[8]

usi8 ds1307_decToBcd(usi8 val) {
    return ((val / 10 * 16) + (val % 10));
}

usi8 ds1307_bcdToDec(usi8 val) {
    return ((val / 16 * 10) + (val % 16));
}

void ds1307_read_time(usi8 j)     
{   
   usi8 i; 
   i2c_start();
   i2c_write(ds13_addr_wr);
   i2c_write(0x00);                     
   i2c_start();               
   i2c_write(ds13_addr_rd);                              
   for(i=0;i<j;i++) time_r[i]=i2c_read();
                                 
   i = i2c_read(0); //not ack, don't care i  
   i2c_stop();
}

void ds1307_update_time(int1 sel)                 
{         
   usi8 i;
   i2c_start();
   i2c_write(ds13_addr_wr);
   i2c_write(0x00);
   for(i=0;i<9;i++)                          
   {  
      if(sel)  i2c_write(time_w[i]);
      else     i2c_write(time_r[i]);
   }                                 
   i2c_stop();        
}  

void ds1307_setup()
{                                              
   ds1307_read_time(9);          
   if(ma_qd!=ma_ds)
   {
      ds1307_update_time(1);
   }
}

void ds1307_save_ds(usi8 dcdt,dt)                 
{           
   i2c_start();
   i2c_write(ds13_addr_wr);        
   i2c_write(dcdt);    
   i2c_write(dt);
   i2c_stop();
}
