VM-Thuan-2003/do_an_1/(commit log)

2024-03-10 dev first commit
    [MACH_TEST_DS18B20 [20240309, 16-10-12].pdsprj, MACH_TEST_DS18B20 [20240309, 16-10-43].pdsprj, MACH_TEST_DS18B20 [20240309, 16-10-52].pdsprj, MACH_TEST_DS18B20 [20240309, 16-10-53].pdsprj, MACH_TEST_DS18B20 [20240309, 16-10-56].pdsprj, MACH_TEST_DS18B20 [20240309, 16-26-28].pdsprj, MACH_TEST_DS18B20 [20240309, 16-27-04].pdsprj, MACH_TEST_DS18B20 [20240309, 16-27-07].pdsprj]
2024-03-12 update code
    [MACH_FINAL [20240312, 16-21-05].pdsprj, MACH_FINAL [20240312, 16-21-10].pdsprj, MACH_FINAL [20240312, 16-21-13].pdsprj, MACH_FINAL [20240312, 16-21-15].pdsprj, MACH_FINAL [20240312, 16-21-17].pdsprj, MACH_FINAL [20240312, 16-21-20].pdsprj, MACH_FINAL [20240312, 16-21-58].pdsprj, MACH_FINAL [20240312, 16-22-00].pdsprj]
2024-03-15 update code do_an_1
    [MACH_FINAL [20240312, 16-21-05].pdsprj, MACH_FINAL [20240312, 16-21-10].pdsprj, MACH_FINAL [20240313, 08-07-43].pdsprj, MACH_FINAL [20240315, 09-30-56].pdsprj, MACH_FINAL.pdsprj]
2024-03-19 dev fix code ds1307
    [MACH_FINAL [20240312, 16-21-13].pdsprj, MACH_FINAL [20240312, 16-21-15].pdsprj, MACH_FINAL [20240312, 16-21-17].pdsprj, MACH_FINAL [20240312, 16-21-20].pdsprj, MACH_FINAL [20240312, 16-21-58].pdsprj, MACH_FINAL [20240312, 16-22-00].pdsprj, MACH_FINAL [20240312, 16-32-43].pdsprj, MACH_FINAL [20240315, 19-27-27].pdsprj]
2024-05-01 update code'
    [1935161.step, MACH_THUC - Copy.dsn, MACH_THUC.kicad_pcb, MACH_THUC.kicad_sch, MACH_THUC_V2.kicad_pcb, MACH_THUC_V2.kicad_sch, PCF8574AT.STEP, SS12D07VG4.step]
2024-06-01 update code final
    [FULL_TEST [20240512, 14-28-11].pdsprj, FULL_TEST [20240512, 14-28-12].pdsprj, FULL_TEST [20240512, 14-34-36].pdsprj, FULL_TEST [20240512, 14-37-23].pdsprj, FULL_TEST [20240512, 17-35-56].pdsprj, FULL_TEST [20240512, 17-36-03].pdsprj, FULL_TEST [20240512, 17-36-04].pdsprj, FULL_TEST [20240512, 17-36-06].pdsprj]
2024-06-09 update final for uart esp and pic16f
    [MACH_TEST_LCD [20240309, 16-08-17].pdsprj, MACH_TEST_LCD [20240609, 18-15-39].pdsprj, MACH_TEST_LCD.pdsprj]
2024-06-20 update for finnal code
    [MACH_THUC.kicad_sch]
